dyu134/licking_meter/Hardware/production/bom.csv

Designator | Footprint | Quantity | Value | LCSC Part #
C1, C2 | 0402 | 2 | 10u
C10, C11, C5, C8, C9 | 0402 | 5 | 0u1
C3 | 0402 | 1 | 15p | C85891
C4 | 0402 | 1 | 1u | C85891
D1 | 0603 | 1 | Red
D2 | D_SOD-123 | 1 | D_Small
D3 | SOT-666 | 1 | USBLC6-2P6
D4 | LED_WS2812B_PLCC4_5.0x5.0mm_P3.2mm | 1 | WS2812B
J2 | USB_C_Receptacle_GCT_USB4105-xx-A_16P_TopMnt_Horizontal | 1 | USB_C_Receptacle_USB2.0_14P
J3 | AFH34-S06FIA-1H | 1 | Conn_01x05_MountingPin
L1 | 0402 | 1 | 3u3
Q1 | SOT-23 | 1 | MMBT4403
R1, R2, R3 | 0402 | 3 | 1k
R22 | 0402 | 1 | 20k
R23 | 0402 | 1 | 8k2
R24, R25 | 0402 | 2 | 100
R26, R27, R6, R7 | 0402 | 4 | 4k7
R4, R5 | 0402 | 2 | 5k1
R8, R9 | 0402 | 2 | 10k | C106225
SW1, SW2, SW3 | SW_SPST_EVQP7A | 3 | SW_Push
U1 | SOT-23-5 | 1 | TLV75733PDBV
U2 | ESP32-S2-MINI-1 | 1 | ESP32-S3-MINI-1
U5 | SOIC-16_3.9x9.9mm_P1.27mm | 1 | HX711
