dyu134/licking_meter/3D Models/Water Bottle Weighing Stand Control Box Lid.stl

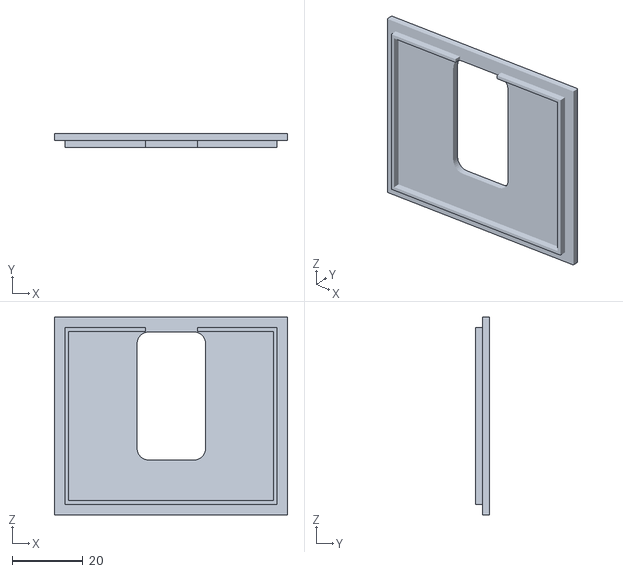
[picture p1: CAD file, 2026-10-31]
3D Models/Water Bottle Weighing Stand Control Box Lid.stl
66.0 x 4.00 x 56.0
