dyu134/licking_meter/3D Models/Water Bottle Weighing Stand v2 Alt Lid.stl

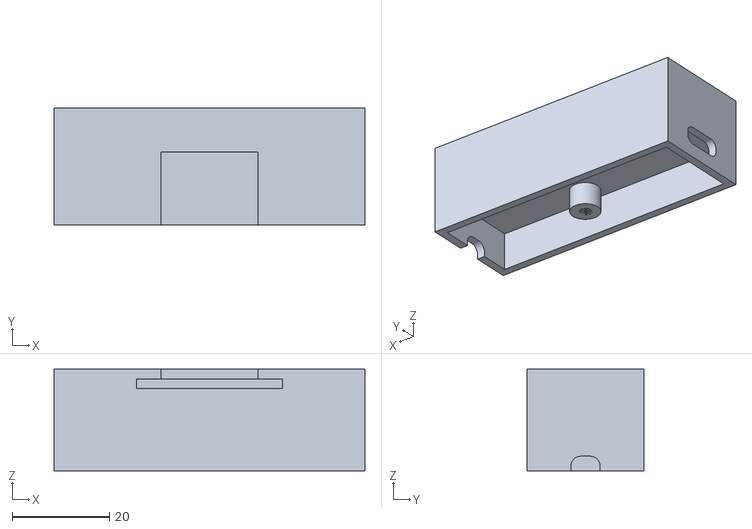
[picture p2: CAD file, 2026-10-31]
3D Models/Water Bottle Weighing Stand v2 Alt Lid.stl
64.0 x 24.0 x 20.9
