dyu134/licking_meter/3D Models/Water Bottle Weight Calibration.stl

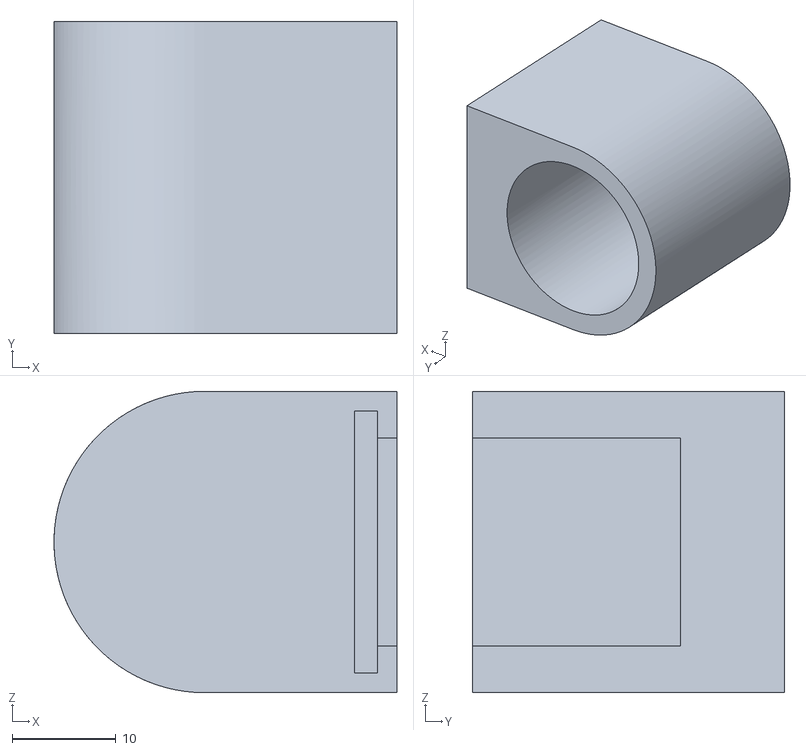
[picture p3: CAD file, 2026-10-31]
3D Models/Water Bottle Weight Calibration.stl
33.0 x 30.0 x 29.0
