dyu134/licking_meter/3D Models/Water Bottle Weighing Stand v2 Button.stl

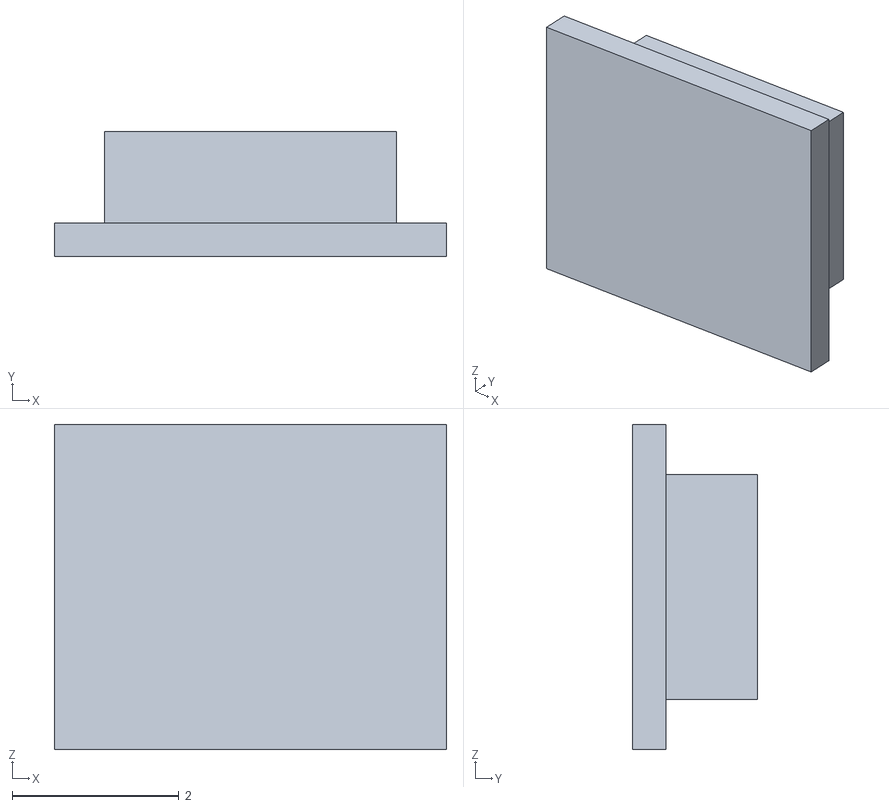
[picture p5: CAD file, 2026-10-31]
3D Models/Water Bottle Weighing Stand v2 Button.stl
4.70 x 1.50 x 3.90
