dyu134/licking_meter/3D Models/Water Bottle Weighing Stand v2.step

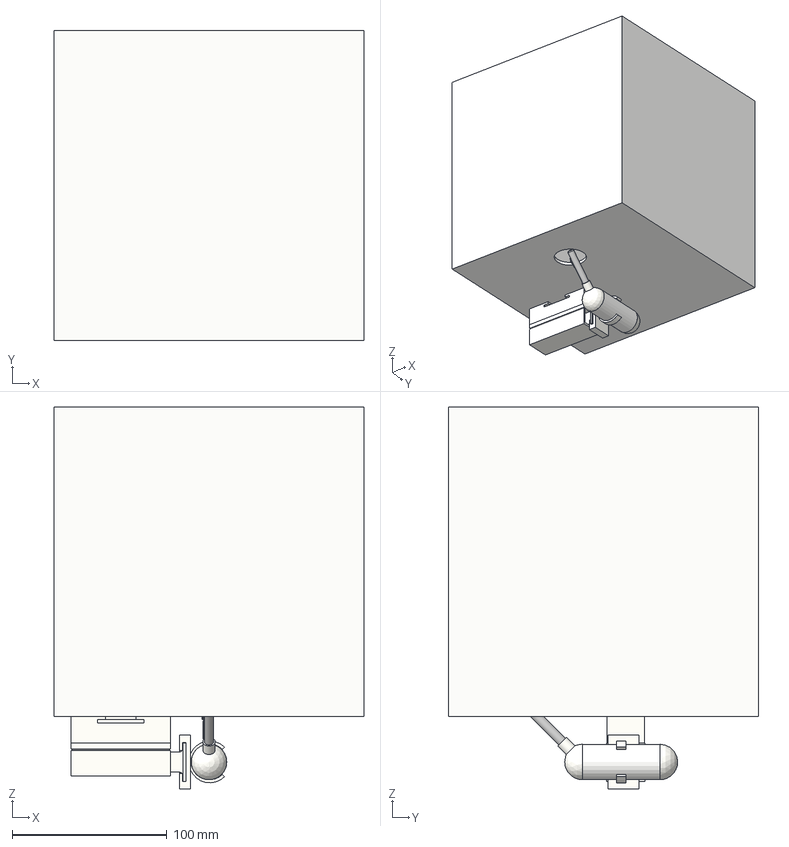
[picture p6: CAD file, 2026-10-31]
3D Models/Water Bottle Weighing Stand v2.step
200.0 x 200.0 x 246.7 mm
R_0402_1005Metric x 22
C_0402_1005Metric x 11
USB_C_Receptacle_GCT_USB4105-xx-A_16P_TopMnt_Horizontal
SW_SPST_EVQP7A x 2
3214W-1-103E
SOT-23-5 x 2
D_SOD-123
MSOP-8_3x3mm_P0.65mm
R_0805_2012Metric x 3
SOT-23
ESP32-S3-MINI-1-N8
LED_0603_1608Metric
SOT-666
SOIC-16_3.9x9.9mm_P1.27mm
L_0402_1005Metric
Water Bottle Scale Backplane Mini_pad
Water Bottle Scale Backplane Mini_PCB
300g Load Cell
Water Bottle Holder
Water Bottle
MLX90393ELW-ABA-011-SP
Water Bottle Sensing FPC 3D Model_PCB
