dyu134/licking_meter/3D Models/Water Bottle Weighing Stand Control Box .stl

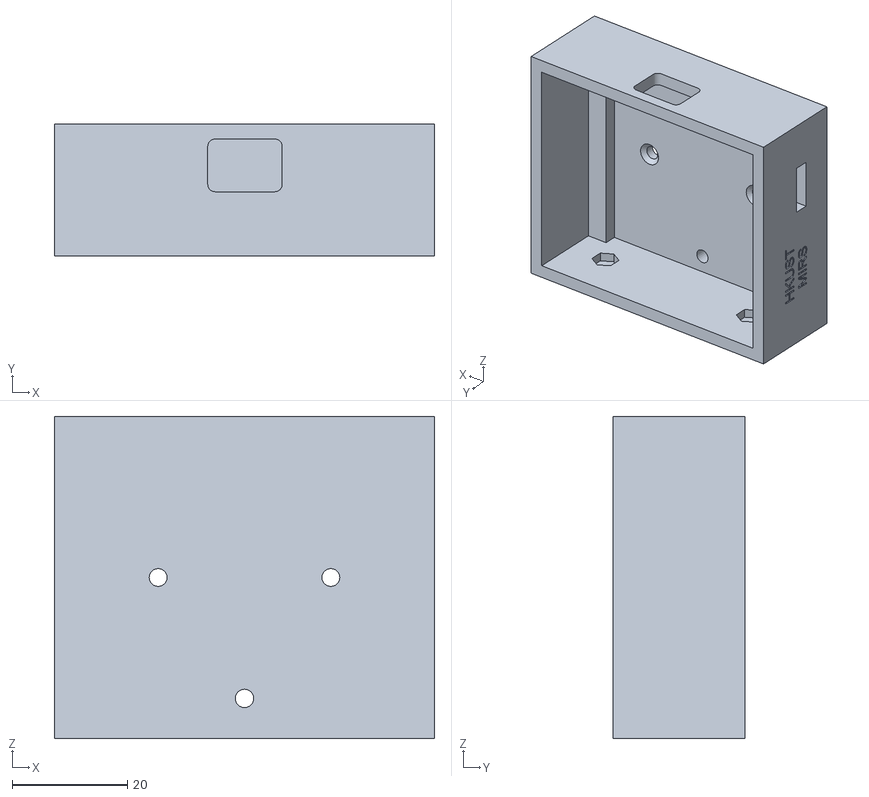
[picture p8: CAD file, 2026-10-31]
3D Models/Water Bottle Weighing Stand Control Box .stl
66.0 x 23.0 x 56.0
