dyu134/licking_meter/3D Models/Water Bottle Weighing Stand v2 Back.stl

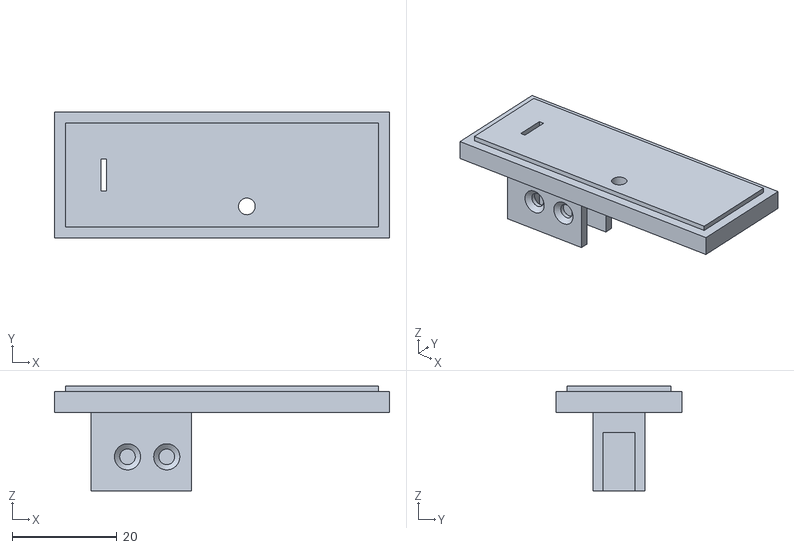
[picture p9: CAD file, 2026-10-31]
3D Models/Water Bottle Weighing Stand v2 Back.stl
64.0 x 24.0 x 20.0
