dyu134/licking_meter/3D Models/Water Bottle Scale Backplane Mini.step

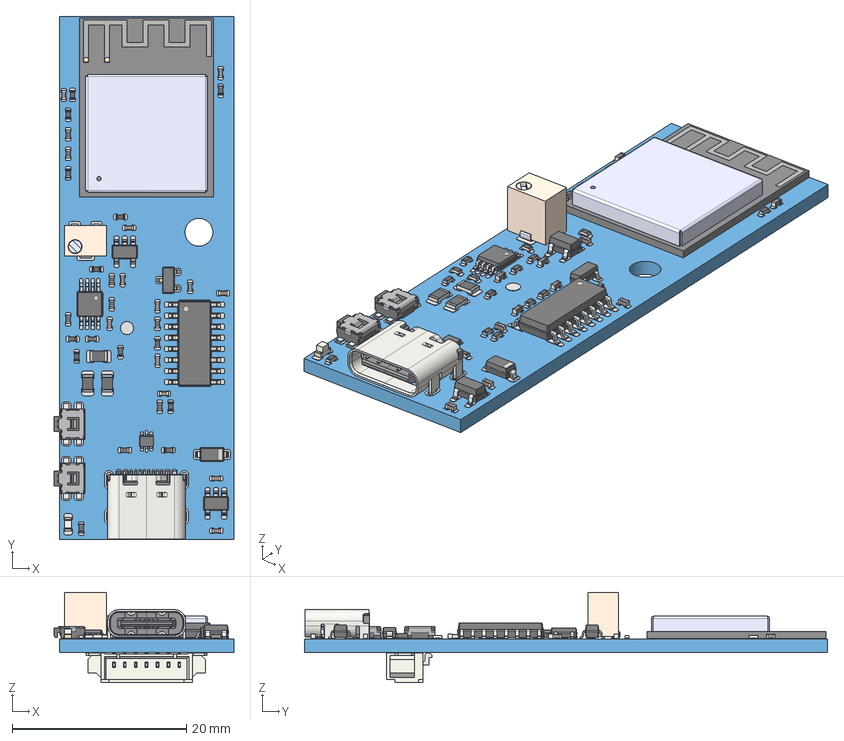
[picture p10: CAD file, 2026-07-05]
3D Models/Water Bottle Scale Backplane Mini.step
20.6 x 60.0 x 10.4 mm
R_0402_1005Metric x 22
C_0402_1005Metric x 11
USB_C_Receptacle_GCT_USB4105-xx-A_16P_TopMnt_Horizontal
SW_SPST_EVQP7A x 2
3214W-1-103E
SOT-23-5 x 2
D_SOD-123
MSOP-8_3x3mm_P0.65mm
R_0805_2012Metric x 3
SOT-23
ESP32-S3-MINI-1-N8
LED_0603_1608Metric
SOT-666
SOIC-16_3.9x9.9mm_P1.27mm
L_0402_1005Metric
Molex_PicoBlade_53261-0771_1x07-1MP_P1.25mm_Horizontal
Water Bottle Scale Backplane Mini_pad
Water Bottle Scale Backplane Mini_PCB
