dyu134/licking_meter/Hardware/Licking_Meter_Schematic.pdf

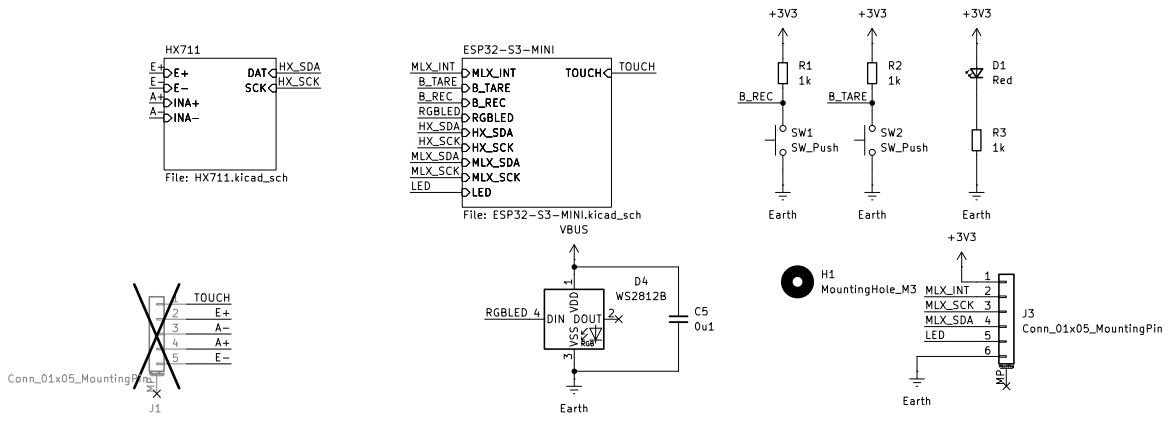
[picture p11: page 1]

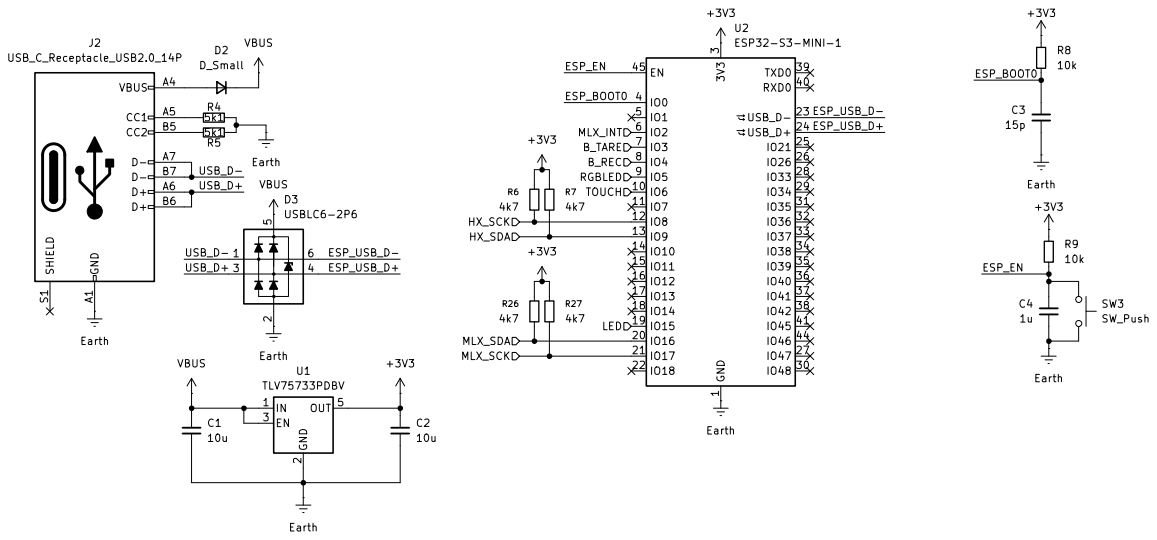
[picture p12: page 2]

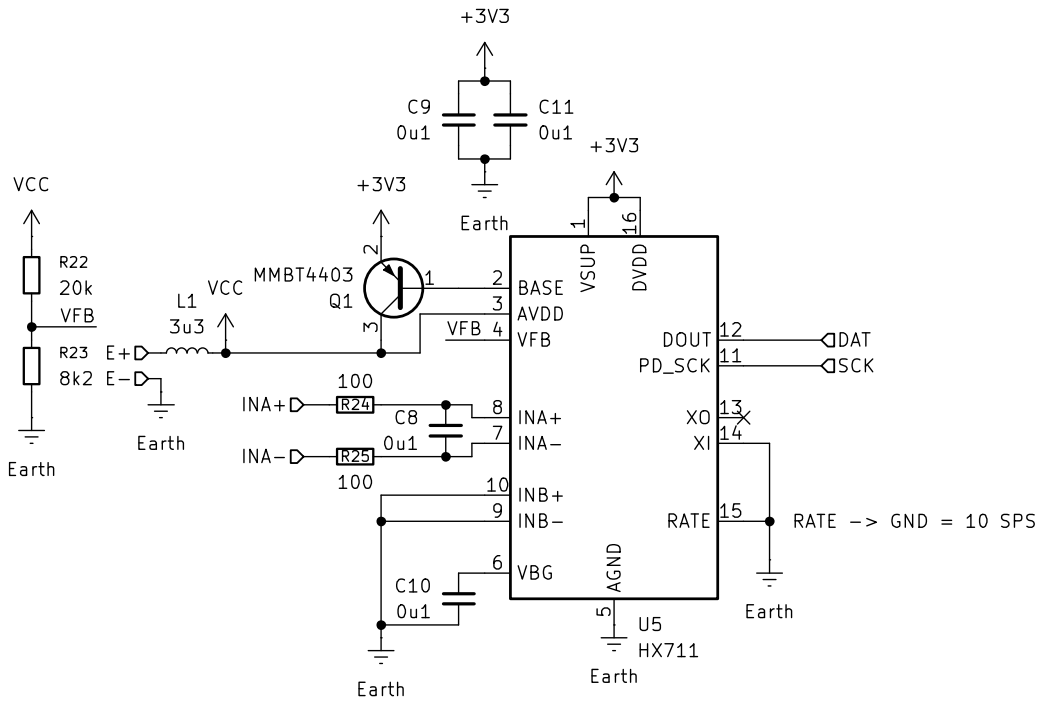
[picture p13: page 3]
