dyu134/licking_meter/Hardware/Water Bottle Scale Backplane Mini.kicad_pcb

## KiCad design Hardware/Water Bottle Scale Backplane Mini.kicad_pcb (2026-07-05)

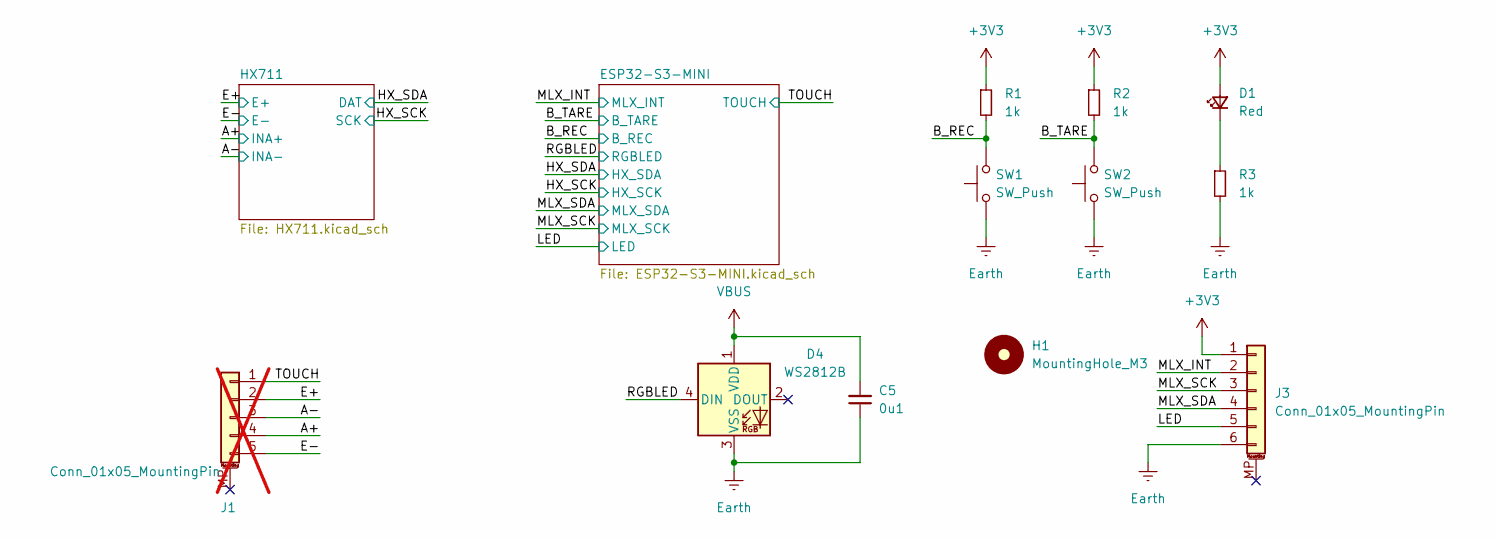
[picture p14: schematic Water Bottle Scale Backplane Mini.kicad_sch, Licking Meter]

Parts:
C5: 0u1; C_0402_1005Metric
D1: Red; LED_0603_1608Metric
D4: WS2812B; LED_WS2812B_PLCC4_5.0x5.0mm_P3.2mm
H1: MountingHole_M3; MountingHole_3.2mm_M3
J1: Conn_01x05_MountingPin; Molex_PicoBlade_53261-0571_1x05-1MP_P1.25mm_Horizontal; not fitted
J3: Conn_01x05_MountingPin; AFH34-S06FIA-1H
R1, R2, R3: 1k; R_0402_1005Metric
SW1, SW2: SW_Push; SW_SPST_EVQP7A

Connections:
+3V3: D1.2 (A), J3.1, R1.1, R2.1; also elsewhere on the board
/A+: J1.4; also elsewhere on the board
/A-: J1.3; also elsewhere on the board
/B_REC: R1.2, SW1.2; also elsewhere on the board
/B_TARE: R2.2, SW2.2; also elsewhere on the board
/E+: J1.2; also elsewhere on the board
/LED: J3.5; also elsewhere on the board
/MLX_INT: J3.2; also elsewhere on the board
/MLX_SCK: J3.3; also elsewhere on the board
/MLX_SDA: J3.4; also elsewhere on the board
/RGBLED: D4.4 (DIN); also elsewhere on the board
/TOUCH: J1.1; also elsewhere on the board
Earth: C5.1, D4.3 (VSS), J1.5, J3.6, R3.2, SW1.1, SW2.1; also elsewhere on the board
unnamed: D1.1 (K), R3.1
VBUS: C5.2, D4.1 (VDD); also elsewhere on the board

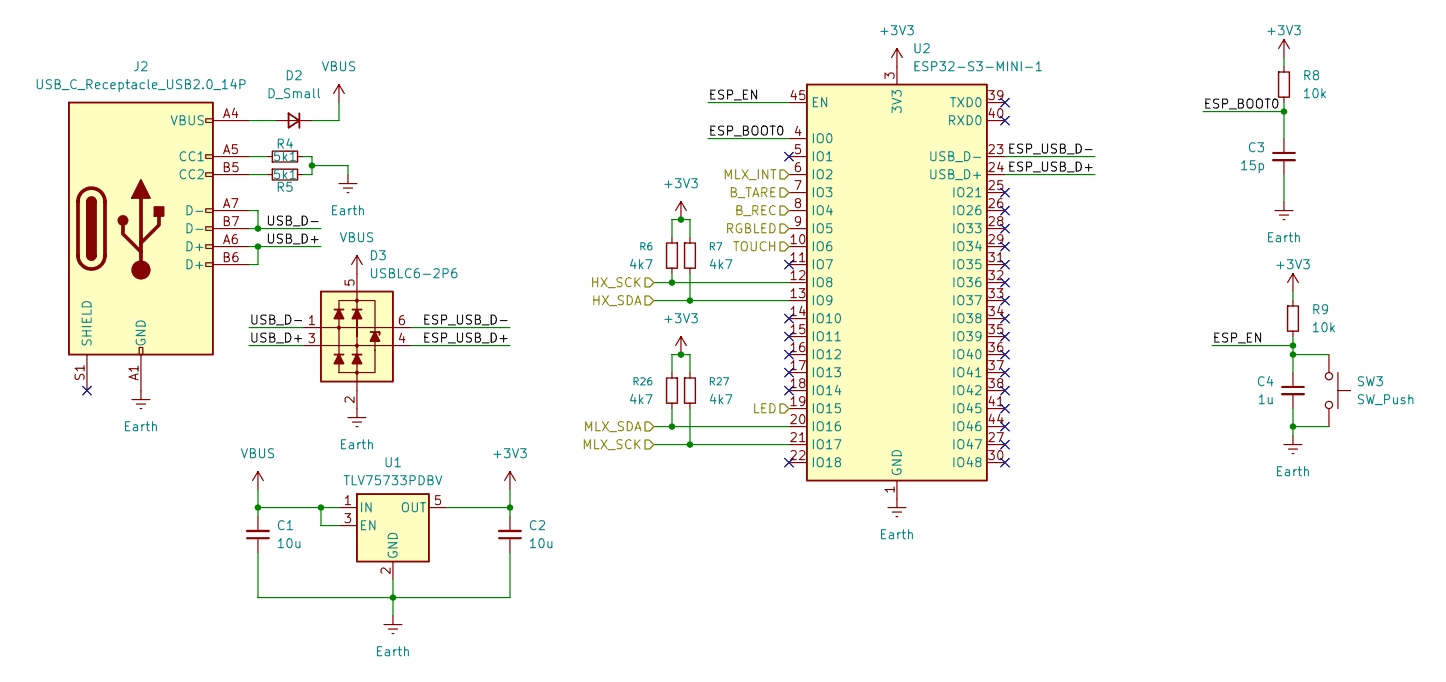
[picture p15: schematic ESP32-S3-MINI.kicad_sch, Licking Meter]

Parts:
C1, C2: 10u; C_0402_1005Metric
C3: 15p; C_0402_1005Metric; LCSC Part No. C85891
C4: 1u; C_0402_1005Metric; LCSC Part No. C85891
D2: D_Small; D_SOD-123
D3: USBLC6-2P6; SOT-666
J2: USB_C_Receptacle_USB2.0_14P; USB_C_Receptacle_GCT_USB4105-xx-A_16P_TopMnt_Horizontal
R4, R5: 5k1; R_0402_1005Metric
R6, R7, R26, R27: 4k7; R_0402_1005Metric
R8, R9: 10k; R_0402_1005Metric; LCSC Part No. C106225
SW3: SW_Push; SW_SPST_EVQP7A
U1: TLV75733PDBV; SOT-23-5
U2: ESP32-S3-MINI-1; ESP32-S2-MINI-1

Connections:
+3V3: C2.2, R6.1, R7.1, R8.1, R9.1, R26.1, R27.1, U1.5 (OUT), U2.3 (3V3); also elsewhere on the board
/B_REC: U2.8 (IO4); also elsewhere on the board
/B_TARE: U2.7 (IO3); also elsewhere on the board
/ESP32-S3-MINI/ESP_BOOT0: C3.1, R8.2, U2.4 (IO0)
/ESP32-S3-MINI/ESP_EN: C4.1, R9.2, SW3.1, U2.45 (EN)
/ESP32-S3-MINI/ESP_USB_D+: D3.4 (L2), U2.24 (USB_D+)
/ESP32-S3-MINI/ESP_USB_D-: D3.6 (L1), U2.23 (USB_D-)
/ESP32-S3-MINI/USB_D+: D3.3 (L2), J2.A6 (D+), J2.B6 (D+)
/ESP32-S3-MINI/USB_D-: D3.1 (L1), J2.A7 (D-), J2.B7 (D-)
/HX_SCK: R6.2, U2.12 (IO8); also elsewhere on the board
/HX_SDA: R7.2, U2.13 (IO9); also elsewhere on the board
/LED: U2.19 (IO15); also elsewhere on the board
/MLX_INT: U2.6 (IO2); also elsewhere on the board
/MLX_SCK: R27.2, U2.21 (IO17); also elsewhere on the board
/MLX_SDA: R26.2, U2.20 (IO16); also elsewhere on the board
/RGBLED: U2.9 (IO5); also elsewhere on the board
/TOUCH: U2.10 (IO6); also elsewhere on the board
Earth: C1.1, C2.1, C3.2, C4.2, D3.2 (VN), J2.A1 (GND), J2.A12 (GND), J2.B1 (GND), J2.B12 (GND), R4.2, R5.2, SW3.2, U1.2 (GND), U2.1 (GND), U2.2 (GND), U2.42 (GND), U2.43 (GND), U2.46 (GND), U2.47 (GND), U2.48 (GND), U2.49 (GND), U2.50 (GND), U2.51 (GND), U2.52 (GND), U2.53 (GND), U2.54 (GND), U2.55 (GND), U2.56 (GND), U2.57 (GND), U2.58 (GND), U2.59 (GND), U2.60 (GND), U2.61 (GND), U2.62 (GND), U2.63 (GND), U2.64 (GND), U2.65 (GND); also elsewhere on the board
unnamed: D2.2 (A), J2.A4 (VBUS), J2.A9 (VBUS), J2.B4 (VBUS), J2.B9 (VBUS)
unnamed: J2.A5 (CC1), R4.1
unnamed: J2.B5 (CC2), R5.1
VBUS: C1.2, D2.1 (K), D3.5 (VP), U1.1 (IN), U1.3 (EN); also elsewhere on the board

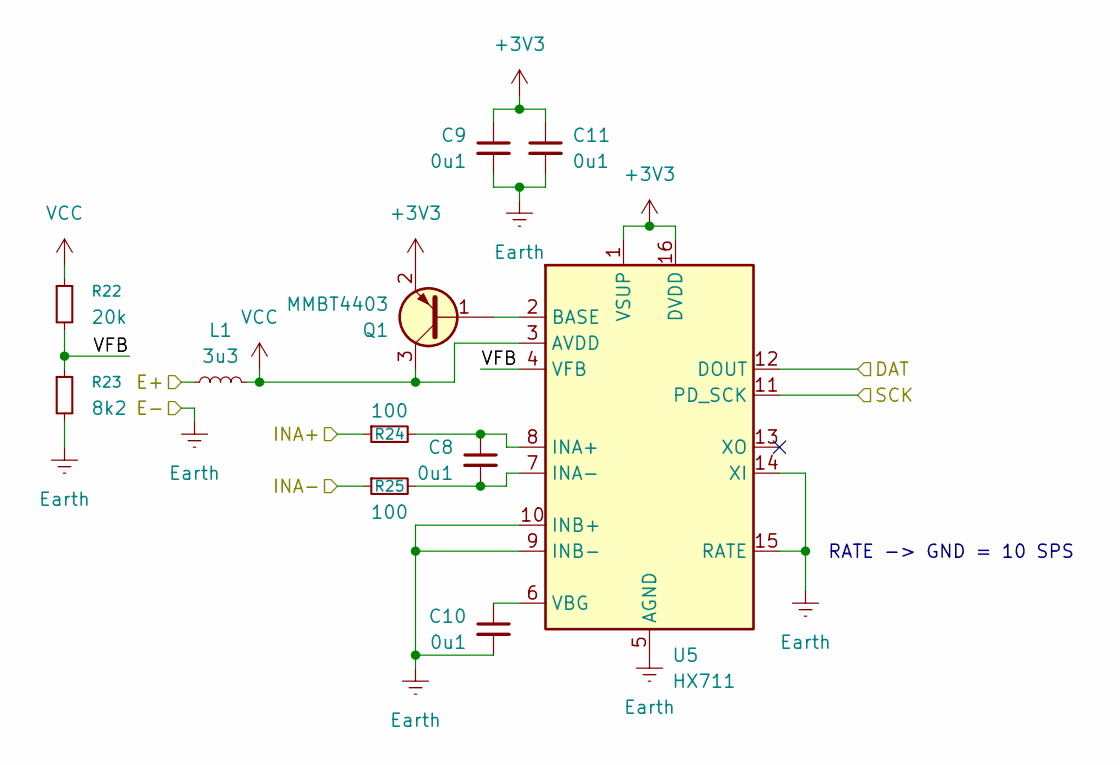
[picture p16: schematic HX711.kicad_sch, Licking Meter]

Parts:
C8, C9, C10, C11: 0u1; C_0402_1005Metric
L1: 3u3; L_0402_1005Metric
Q1: MMBT4403; SOT-23
R22: 20k; R_0402_1005Metric
R23: 8k2; R_0402_1005Metric
R24, R25: 100; R_0402_1005Metric
U5: HX711; SOIC-16_3.9x9.9mm_P1.27mm

Connections:
+3V3: C9.1, C11.1, Q1.2 (E), U5.1 (VSUP), U5.16 (DVDD); also elsewhere on the board
/A+: R24.1; also elsewhere on the board
/A-: R25.1; also elsewhere on the board
/E+: L1.1; also elsewhere on the board
/HX711/VFB: R22.2, R23.1, U5.4 (VFB)
/HX_SCK: U5.11 (PD_SCK); also elsewhere on the board
/HX_SDA: U5.12 (DOUT); also elsewhere on the board
Earth: C9.2, C10.2, C11.2, R23.2, U5.5 (AGND), U5.9 (INB-), U5.10 (INB+), U5.14 (XI), U5.15 (RATE); also elsewhere on the board
unnamed: Q1.1 (B), U5.2 (BASE)
unnamed: C8.1, R24.2, U5.8 (INA+)
unnamed: C8.2, R25.2, U5.7 (INA-)
unnamed: C10.1, U5.6 (VBG)
VCC: L1.2, Q1.3 (C), R22.1, U5.3 (AVDD)

Notes on the sheet:
RATE -> GND = 10 SPS

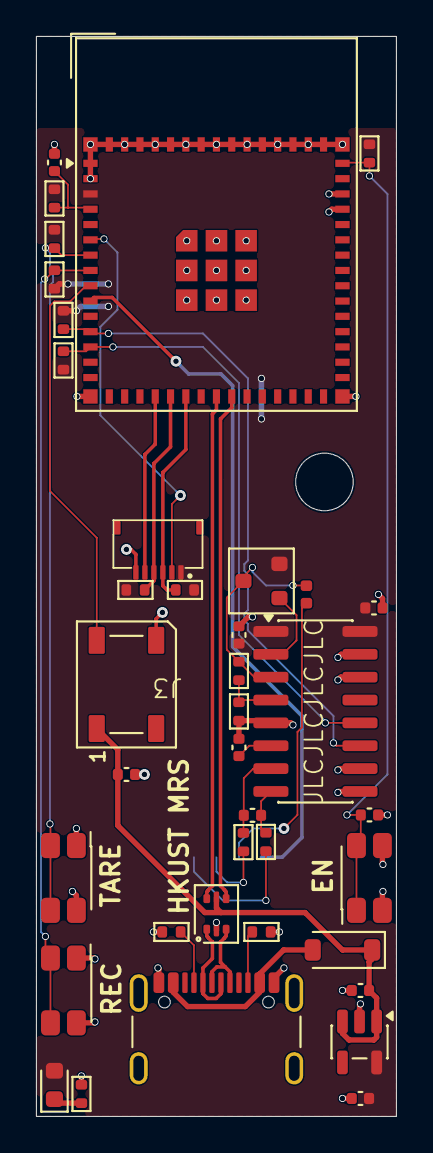
[picture p17: board Water Bottle Scale Backplane Mini.kicad_pcb from above]

Board: 2 copper layers, 20.0 x 60.0 mm, 40 parts (1 on the bottom side), 32 nets.
